tmpk13/PTT-Switch/ptt-switch/3D-models/CH572D-QFN20-3x3mm-Extrude.step

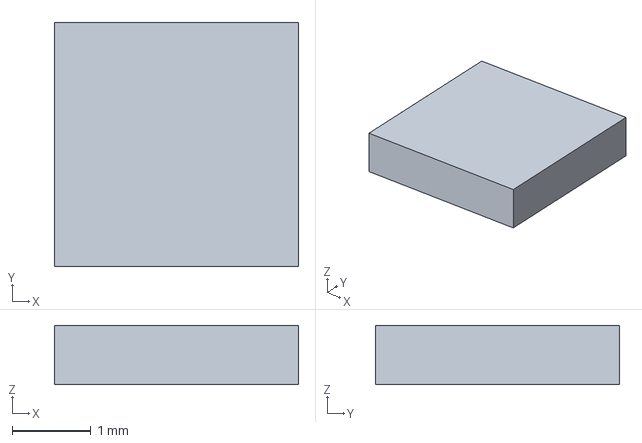
[picture p1: CAD file, 2026-11-12]
ptt-switch/3D-models/CH572D-QFN20-3x3mm-Extrude.step
3.10 x 3.10 x 0.75 mm
