tmpk13/PTT-Switch/ptt-switch/ptt-switch.kicad_pcb

## KiCad design ptt-switch/ptt-switch.kicad_pcb (2026-11-12)

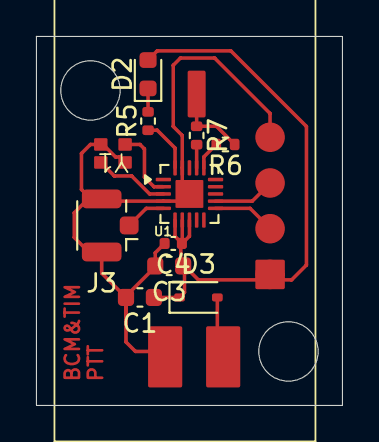
[picture p2: board ptt-switch.kicad_pcb from above]

Board: 2 copper layers, 17.0 x 20.5 mm, 11 parts (0 on the bottom side), 10 nets.

Parts:
C1: 100u; C_0603_1608Metric
C3: 2.2u; C_0603_1608Metric
C4: 100n; C_0402_1005Metric
D2: LED; LED_0603_1608Metric
D3: BAT54WS; D_SOD-323
J3: U.FL; U.FL_Hirose_U.FL-R-SMT-1_Vertical
R5: 1k; R_0402_1005Metric
R6: 10k; R_0402_1005Metric
R7: 1M; R_0402_1005Metric
U1: CH572D
Y1: 32MHz; XRCGB32M000F1S1DR0

Connections:
+3V3: C1.1, C3.1, C4.1, D2.2 (A), D3.1 (K), U1.6 (VDD33), U1.7 (VIO33), U1.8 (V5)
/ANT: J3.1 (In), U1.5 (ANT)
/TOUCH: R6.1, R7.1
GND: C1.2, C3.2, C4.2, J3.2 (Ext), U1.4 (NC), U1.19 (NC), U1.21 (GND), Y1.2
unnamed: D2.1 (K), R5.2
unnamed: R5.1, U1.20 (PA2)
unnamed: R6.2, U1.16 (PA7)
unnamed: R7.2, U1.17 (PA10)
unnamed: U1.3 (XI), Y1.3
unnamed: U1.2 (XO), Y1.1
