tmpk13/PTT-Switch/(commit log)

2026-11-12 Port the CH572D circuit from AGRV2KL48-fpga, add the touch wire and antenna
    The CH572D sheet of AGRV2KL48-fpga becomes this project's root sheet:
    USB-C, AP2112K-3.3, CH572D in single 3.3 V mode, 32 MHz crystal, two LEDs
    and the ROM-bootloader jumper. The AG32 bridge nets and their resistors
    are gone and references are renumbered for this board.
    Touch: PA10 charges the wire pad J2 through R7 (1M); PA7, the
    comparator's CMP_P1 input, senses it through R6 (10k). The CH572 has no
    touch peripheral or ADC, so firmware times the rise against the
    comparator's internal reference.
    Antenna: ANT through a pi-match placeholder (C5, C6 DNP, R8 0R) to a U.FL.
    Tests check the CH572D symbol and footprint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
    [CH572D-QFN20-3x3mm-Extrude.step, ptt-switch.kicad_pcb, ptt-switch.kicad_sch]
2026-11-12 Add a parametric FreeCAD enclosure for the board
    enclosure/box.py builds a two-part box under freecadcmd from
    enclosure/params.toml: a base tray with four screw standoffs and a USB-C
    opening in the -X end wall, and a lid with a friction-fit lip and a finger
    dimple that thins it over the touch wire. Every dimension is a cell of the
    document's Params spreadsheet and every feature reads it through
    expressions, so the FCStd stays parametric in the GUI. All values are
    placeholders until the board and touch wire layout are final.
    box.check rejects values that build but do not work (lip reaching the PCB,
    opening behind the lip or in the floor, dimple past the cavity, pilot hole
    wider than its stan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
2026-11-12 Checkpoint the Eeschema and Pcbnew edits before the battery rework
    Saved from the GUI as found: U2 (AP2112K-3.3) with C1/C2, the VBUS
    symbol and both PWR_FLAGs are gone from the schematic, which is
    rearranged; the PCB holds a first footprint import (no outline, no
    tracks, still U2/C1/C2, no U1/Y1) and the project file its settings.
    Not passing at this commit: the netlist tests still expect U2 and VBUS,
    and ERC reports the undriven +3V3 and the open VBUS pin.
    [ptt-switch.kicad_pcb, ptt-switch.kicad_sch]
2026-11-12 Run from a Li-SOCl2 cell and flash over SWD instead of USB-C
    The USB-C port goes (J1, R1/R2, JP1/R3; U2 went in the GUI). A 3.6 V
    Li-SOCl2 cell on J1 (JST PH) feeds VDD33/VIO33/V5 directly through D3
    (BAT54WS), with C1 (100 uF ceramic) for the radio bursts. The CH572's
    own LDO5V needs 4.5 V or more on V5, so single-supply mode takes the
    cell; D3 keeps the programmer's 3.3 V and a reversed cell from charging
    the primary cell and holds a fresh cell under the 3.6 V limit.
    J4 (1x04) brings out SWDIO/SWCLK on PA0/PA1 for a WCH-LinkE; the old
    USB_D-/USB_D+ labels at U1 are now SWDIO/SWCLK. PWR_FLAGs on +3V3 and
    GND keep ERC clean. Tests, NOTES (Power, Flashing), ARCHITECTURE and
    README follow.
    C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
    [ptt-switch.kicad_sch]
2026-11-12 Add the CH572D firmware: touch wire state over BLE, asleep between polls
    Rust firmware in firmware/, started from ch572-bridge-rs (startup, clock,
    WCH BLE bindings). Not yet run on hardware.
    - Touch: PA10 charges the wire through R7, the timer captures the
    comparator (PA7 against 800 mV); four charges per poll, a detector
    with a drifting baseline, hysteresis and a 2 minute stuck limit.
    - BLE on WCH's peripheral library: one service with touch (read,
    notify), device ID and diagnostics; the touch state also rides in the
    advertising data. docs/BLE.md is the contract for the Android app.
    - Power: WCH's HAL_SLEEP path. TMOS's idle hook sets the RTC alarm
    1.6 ms before the next event an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
    [ble.rs, build.rs, hw.rs, lib.rs, main.rs, protocol.rs, regs.rs, sleep.rs]
2026-11-12 Add gerbers
    [ptt-switch-B_Cu.gbr, ptt-switch-B_Mask.gbr, ptt-switch-B_Paste.gbr, ptt-switch-B_Silkscreen.gbr, ptt-switch-Edge_Cuts.gbr, ptt-switch-F_Cu.gbr, ptt-switch-F_Mask.gbr, ptt-switch-F_Paste.gbr]
2026-11-12 Add the Android app: finds a board and shows its touch wire's state
    android/ is a plain-Java app built by android/build.sh with the SDK's
    command-line tools, no Gradle (24 KB APK). Link scans for the board's
    service UUID, shows the advertised touch value, connects, subscribes to
    the touch characteristic and rescans after a dropped link; MainActivity
    shows TOUCHED / RELEASED in a large pad, asks for Nearby devices and for
    Bluetooth to be on, and follows Bluetooth being switched off and on.
    tests/test_android.py runs Protocol.java on the desktop JVM: its UUIDs
    and company ID against firmware/src/protocol.rs and docs/BLE.md, and
    the touch values the firmware sends. Checked on an API 33 emulato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
2026-11-12 Update for 1 layer
    [ptt-switch-B_Cu.gbr, ptt-switch-B_Mask.gbr, ptt-switch-B_Paste.gbr, ptt-switch-B_Silkscreen.gbr, ptt-switch-Edge_Cuts.gbr, ptt-switch-F_Cu.gbr, ptt-switch-F_Mask.gbr, ptt-switch-F_Paste.gbr]
2026-11-12 Add housing 3D model.
